CRLG/HW_POWER_ELECTROBOT/README.md

# HW_POWER_ELECTROBOT
Carte électronique POWER_ELECTROBOT : schéma et routage
