CRLG/HW_POWER_ELECTROBOT/output/PowerElectrobot.pdf

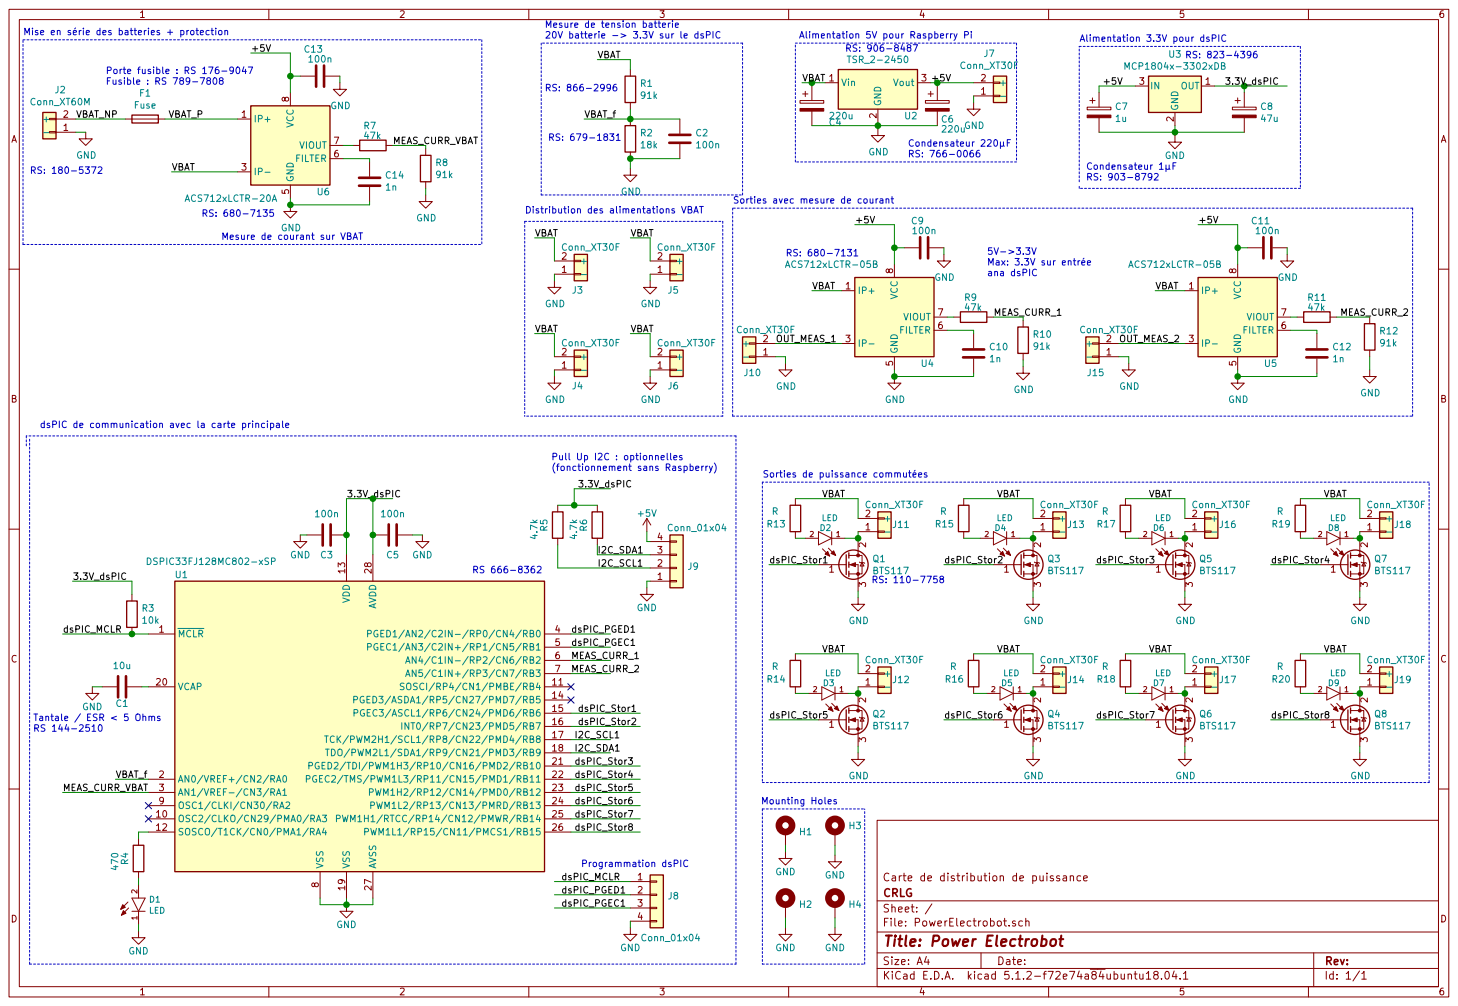
[picture p1: page 1]

100n Mesure de tension batterie
20V batterie -> 3.3V sur le dsPIC GND
VBAT VBAT_f Distribution des alimentations VBAT
220u Mounting Holes

Alimentation 5V pour Raspberry Pi R1

Condensateur 1µF RS: 903-8792 Condensateur 220µF RS: 766-0066

5V->3.3V Max: 3.3V sur entrée ana dsPIC

VBAT Sorties de puissance commutées

Carte de distribution de puissance
Id: 1/1 Title: Power Electrobot File: PowerElectrobot.sch Sheet: / CRLG
