CRLG/HW_POWER_ELECTROBOT/PowerElectrobot.kicad_pcb

## KiCad design PowerElectrobot.kicad_pcb (2020-08-28)

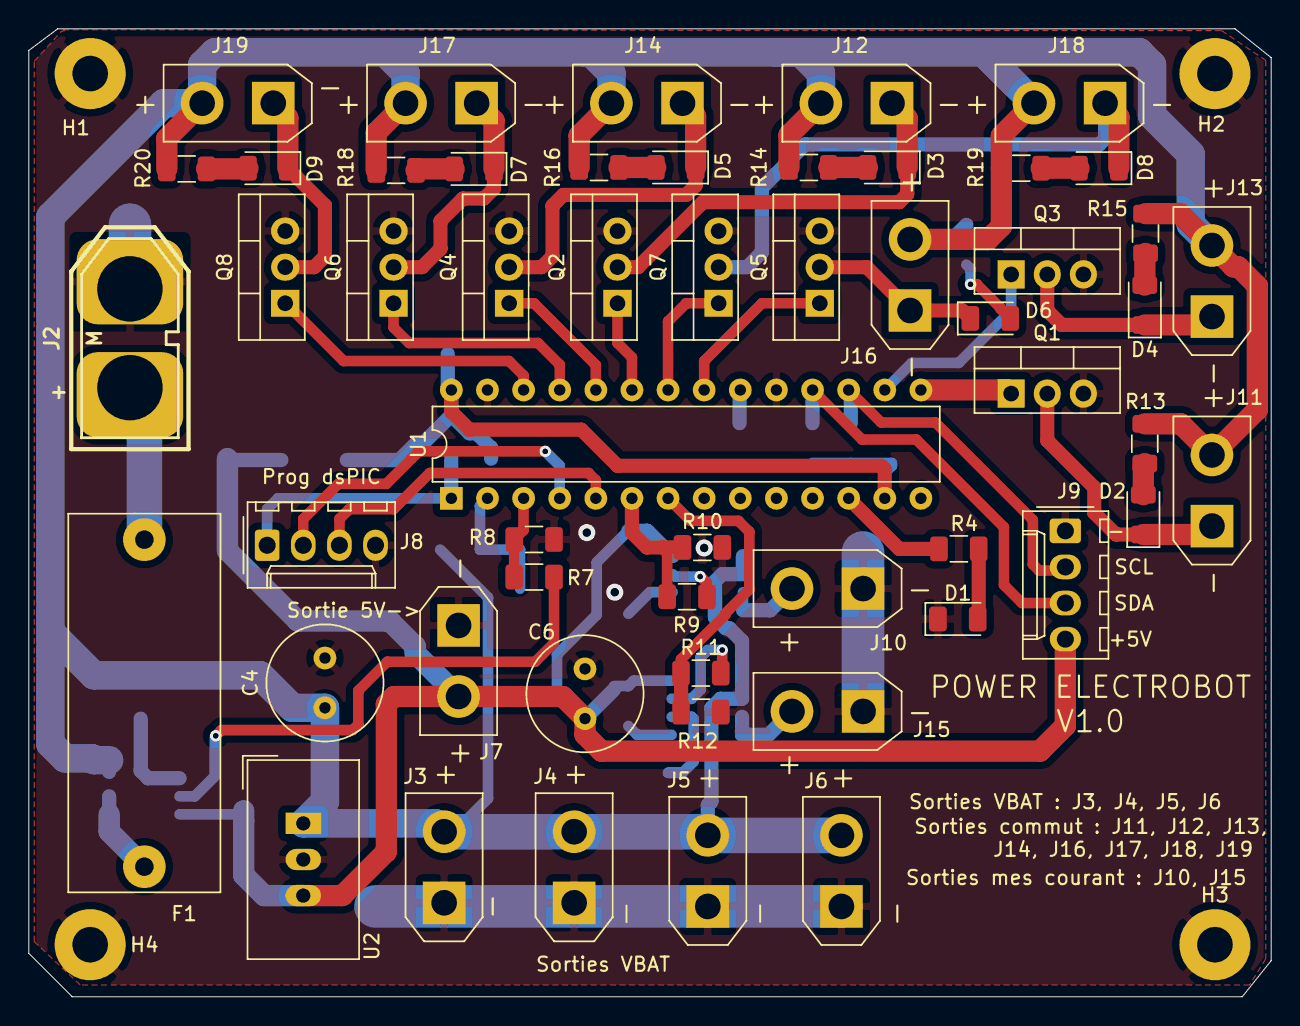
[picture p2: board PowerElectrobot.kicad_pcb from above]

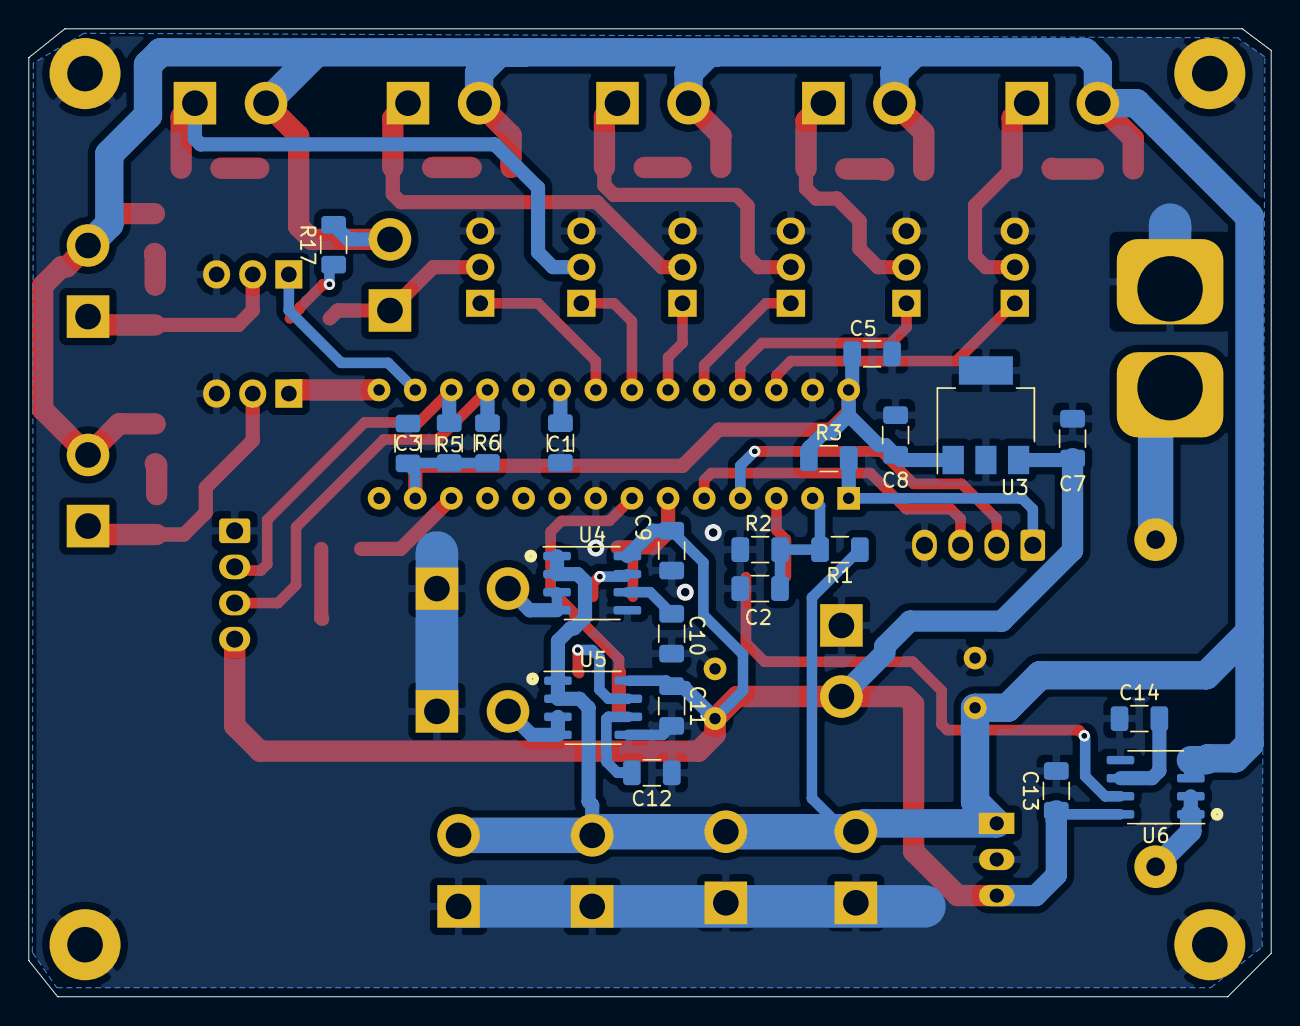
[picture p3: board PowerElectrobot.kicad_pcb from below]

Board: 2 copper layers, 87.4 x 68.1 mm, 80 parts (22 on the bottom side), 50 nets.

Parts:
C1: 10u; C_1206_3216Metric
C2, C3, C5, C9, C11, C13: 100n; C_1206_3216Metric
C4, C6: 220u; C_Radial_D8.0mm_H11.5mm_P3.50mm
C7: 1u; C_1206_3216Metric
C8: 47u; C_1206_3216Metric
C10, C12, C14: 1n; C_1206_3216Metric
D1, D2, D3, D4, D5, D6, D7, D8, D9: LED; LED_1206_3216Metric
F1: Fuse; Fuseholder_Schurter-5x20mm
H1, H2, H3, H4: MountingHole_Pad; MountingHole_2.5mm_Pad
J2: Conn_XT60M; XT60UPB-M
J3, J4, J5, J6, J7, J10, J11, J12, J13, J14, J15, J16, J17, J18, J19: Conn_XT30F; AMASS_XT30UPB-F_1x02_P5.0mm_Vertical
J8, J9: Conn_01x04; Molex_KK-254_AE-6410-04A_1x04_P2.54mm_Vertical
Q1, Q2, Q3, Q4, Q5, Q6, Q7, Q8: BTS117; TO-220-3_Vertical
R1, R8, R10, R12: 91k; R_1206_3216Metric
R2: 18k; R_1206_3216Metric
R3: 10k; R_1206_3216Metric
R4: 470; R_1206_3216Metric
R5, R6: 4.7k; R_1206_3216Metric
R7, R9, R11: 47k; R_1206_3216Metric
R13, R14, R15, R16, R17, R18, R19, R20: R; R_1206_3216Metric
U1: DSPIC33FJ128MC802-xSP; DIP-28_W7.62mm
U2: TSR_2-2450; Converter_DCDC_TRACO_TSR-2_THT
U3: MCP1804x-3302xDB; SOT-223-3_TabPin2
U4, U5: ACS712xLCTR-05B; SOIC-8_3.9x4.9mm_P1.27mm
U6: ACS712xLCTR-20A; SOIC-8_3.9x4.9mm_P1.27mm

Connections:
+5V: C6.1, C7.1, C9.1, C11.1, C13.1, J7.2, J9.4, U2.3, U3.3, U4.8, U5.8, U6.8
/3.3V_dsPIC: C3.1, C5.2, C8.1, R3.1, R5.2, R6.2, U1.13, U1.28, U3.1
/I2C_SCL1: J9.2, R5.1, U1.17
/I2C_SDA1: J9.3, R6.1, U1.18
/MEAS_CURR_1: R9.1, R10.1, U1.6
/MEAS_CURR_2: R11.1, R12.1, U1.7
/MEAS_CURR_VBAT: R7.1, R8.1, U1.3
/OUT_MEAS_1: J10.2, U4.3, U4.4
/OUT_MEAS_2: J15.2, U5.3, U5.4
/VBAT: C4.1, J3.2, J4.2, J5.2, J6.2, J11.2, J12.2, J13.2, J14.2, J16.2, J17.2, J18.2, J19.2, R1.1, R13.2, R14.2, R15.2, R16.2, R17.2, R18.2, R19.2, R20.2, U2.1, U4.1, U4.2, U5.1, U5.2, U6.3, U6.4
/VBAT_NP: F1.2, J2.2
/VBAT_P: F1.1, U6.1, U6.2
/VBAT_f: C2.1, R1.2, R2.1, U1.2
/dsPIC_MCLR: J8.1, R3.2, U1.1
/dsPIC_PGEC1: J8.3, U1.5
/dsPIC_PGED1: J8.2, U1.4
/dsPIC_Stor1: Q1.1, U1.15
/dsPIC_Stor2: Q3.1, U1.16
/dsPIC_Stor3: Q5.1, U1.21
/dsPIC_Stor4: Q7.1, U1.22
/dsPIC_Stor5: Q2.1, U1.23
/dsPIC_Stor6: Q4.1, U1.24
/dsPIC_Stor7: Q6.1, U1.25
/dsPIC_Stor8: Q8.1, U1.26
GND: C1.2, C2.2, C3.2, C4.2, C5.1, C6.2, C7.2, C8.2, C9.2, C10.1, C11.2, C12.1, C13.2, C14.1, D1.1, H1.1, H2.1, H3.1, H4.1, J2.1, J3.1, J4.1, J5.1, J6.1, J7.1, J8.4, J9.1, J10.1, J15.1, Q1.3, Q2.3, Q3.3, Q4.3, Q5.3, Q6.3, Q7.3, Q8.3, R2.2, R8.2, R10.2, R12.2, U1.8, U1.19, U1.27, U2.2, U3.2, U4.5, U5.5, U6.5
unnamed: C1.1, U1.20
unnamed: C10.2, U4.6
unnamed: C12.2, U5.6
unnamed: C14.2, U6.6
unnamed: D1.2, R4.1
unnamed: D2.1, J11.1, Q1.2
unnamed: D2.2, R13.1
unnamed: D3.1, J12.1, Q2.2
unnamed: D3.2, R14.1
unnamed: D4.1, J13.1, Q3.2
unnamed: D4.2, R15.1
unnamed: D5.1, J14.1, Q4.2
unnamed: D5.2, R16.1
unnamed: D6.1, J16.1, Q5.2
unnamed: D6.2, R17.1
unnamed: D7.1, J17.1, Q6.2
unnamed: D7.2, R18.1
unnamed: D8.1, J18.1, Q7.2
unnamed: D8.2, R19.1
unnamed: D9.1, J19.1, Q8.2
unnamed: D9.2, R20.1
unnamed: R4.2, U1.12
unnamed: R7.2, U6.7
unnamed: R9.2, U4.7
unnamed: R11.2, U5.7
