CRLG/HW_POWER_ELECTROBOT/(commit log)

2019-06-23 Ajout de KICAD_LIB comme sous-module du projet
    KICAD_LIB est la librairie de composants et footprints CRLG pour KICAD
2019-07-24 Version initiale du projet
    [PowerElectrobot.kicad_pcb, PowerElectrobot.sch]
2019-07-27 Mise à jour schématique
    [PowerElectrobot.sch]
2019-07-29 Mise à jour lib kicad
2019-07-30 Mise à jour KICAD_LIB
2019-07-30 Mise à jour schématique : condensateurs
    [PowerElectrobot.sch]
2019-08-02 Mise à jour schématique (fusible, mesure courant VBAT)
    Suiteà discussion avec Alex
    [PowerElectrobot.sch]
2019-08-02 Version initiale du PCB: placement des composants
    [PowerElectrobot.kicad_pcb]
2019-08-02 PCB : création des tailles de pistes
    [PowerElectrobot.kicad_pcb]
2019-08-03 Création des via de 1.2mm
    [PowerElectrobot.kicad_pcb]
2019-08-07 Début du routage de la carte
    [PowerElectrobot.kicad_pcb]
2019-08-07 mise a jour pcb
    [PowerElectrobot.kicad_pcb]
2019-09-01 Correction valeur de résistance LED à 470 Ohms
    [PowerElectrobot.sch]
2019-09-02 Ajout d'une division de tension sur les entrées analogiques mesures de courant.
    Protection du dsPIC à 3.3V (entrées analogiques non tolérantes au 5V)
    [PowerElectrobot.sch]
2019-09-02 Ajout des LEDs de debug sur les sorties pilotées
    [PowerElectrobot.sch]
2019-09-02 Version initiale du placement de composants
    [PowerElectrobot.kicad_pcb]
2019-09-03 Version initiale du routage
    [PowerElectrobot.kicad_pcb]
2019-09-03 Ajout sérigraphie et dimensions
    [PowerElectrobot.kicad_pcb]
2019-09-15 Mise à jour empreinte XT60 + génération gerber
    [PowerElectrobot-B_Cu.gbr, PowerElectrobot-B_Mask.gbr, PowerElectrobot-B_Paste.gbr, PowerElectrobot-B_SilkS.gbr, PowerElectrobot-Edge_Cuts.gbr, PowerElectrobot-F_Cu.gbr, PowerElectrobot-F_Mask.gbr, PowerElectrobot-F_Paste.gbr]
2019-09-15 Ajout des dimensions sur le PCB
    [PowerElectrobot.kicad_pcb]
2019-09-15 Fichiers gerber
    [PowerElectrobot-B_Cu.gbr, PowerElectrobot-B_Mask.gbr, PowerElectrobot-B_Paste.gbr, PowerElectrobot-B_SilkS.gbr, PowerElectrobot-Edge_Cuts.gbr, PowerElectrobot-F_Cu.gbr, PowerElectrobot-F_Mask.gbr, PowerElectrobot-F_Paste.gbr]
2019-09-22 Ajout de la BOM : liste des composants<->Réfrences RS
    [BOM-PowerElectrobot.csv]
2020-08-28 Mise à jour des modèles 3D des connecteurs XT30 et XT60
    [PowerElectrobot.kicad_pcb]
